corytomlinson-oss/diyspeaker/floorstanding-tower/cad/profile.png

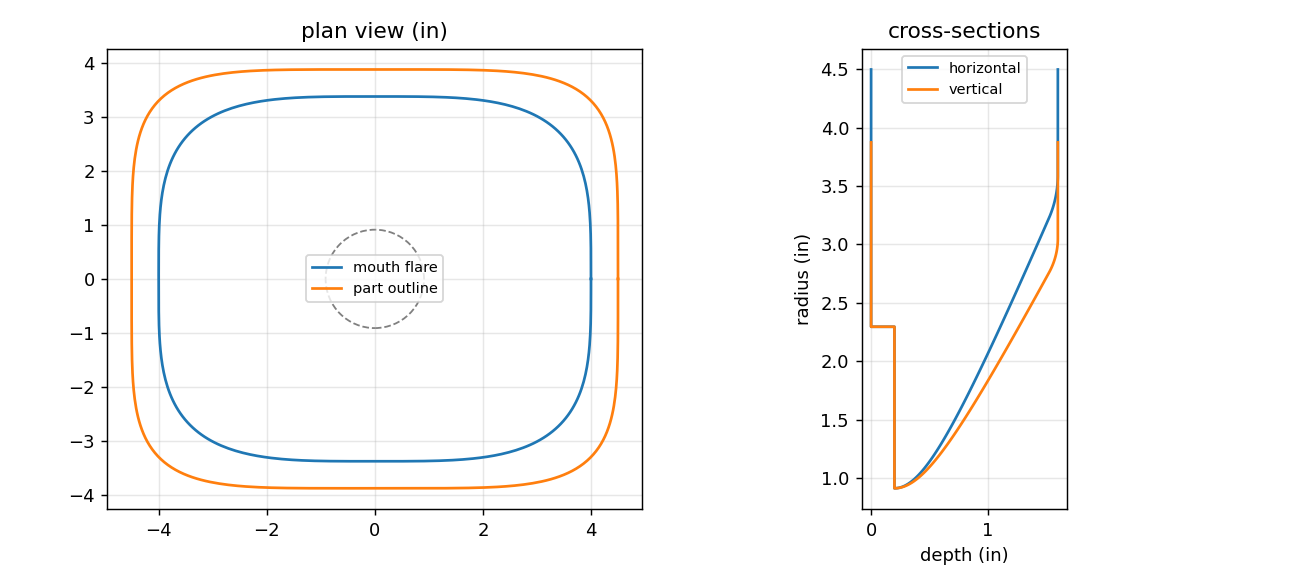
floorstanding-tower/cad/profile.png
