corytomlinson-oss/diyspeaker/floorstanding-tower/cad/testfit_ring.stl

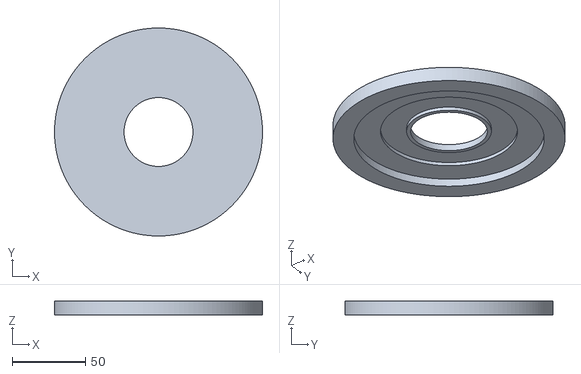
[picture p2: CAD file, 2026-11-09]
floorstanding-tower/cad/testfit_ring.stl
142.0 x 142.0 x 9.37
