corytomlinson-oss/diyspeaker/floorstanding-tower/cad/waveguide.stl

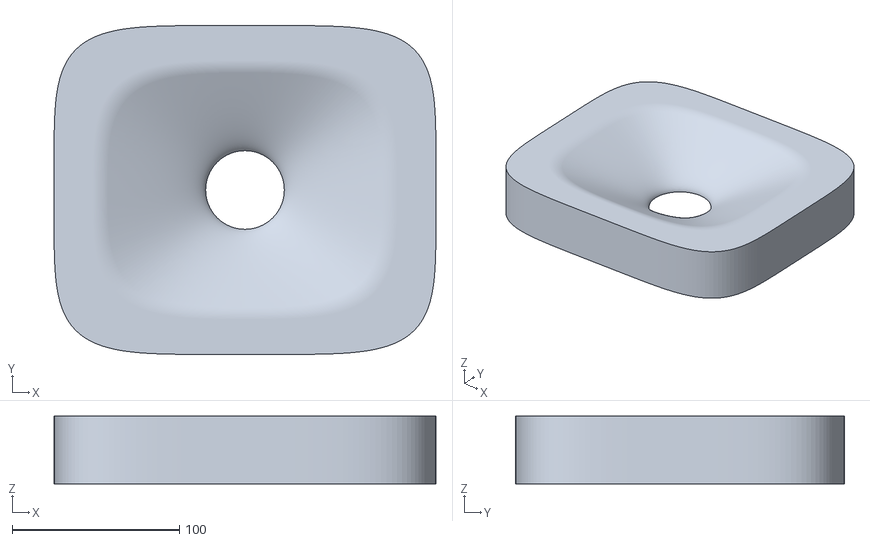
[picture p3: CAD file, 2026-11-09]
floorstanding-tower/cad/waveguide.stl
228.6 x 196.9 x 40.6
