corytomlinson-oss/diyspeaker/(commit log)

2026-10-29 Update studio-monitors for 3D-printed direction
    Claude-Session: https://claude.ai/code/session_0119Lay92K6dQtt6seaHzskN
2026-11-04 Switch woofer to Peerless SLS-85S25CP04-04
    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
2026-11-09 Add PCM1808 board static and functional test guide
    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
2026-11-09 Replace JST terminals and crimp tool with pre-made VH cable assemblies
    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
2026-11-09 Add floorstanding-tower project: 2.5-way tower design record, sims, waveguide generator and STLs
    Claude-Session: https://claude.ai/code/session_0113gZ1xHgRv1x51x5LaT1r4
    [testfit_ring.stl, waveguide.stl]
